mariusmym/Macro-Keypad/SCHEMATIC/Schematic_REFLOW_PLATE_CS2024_v1.2.2_2026-10-07.png

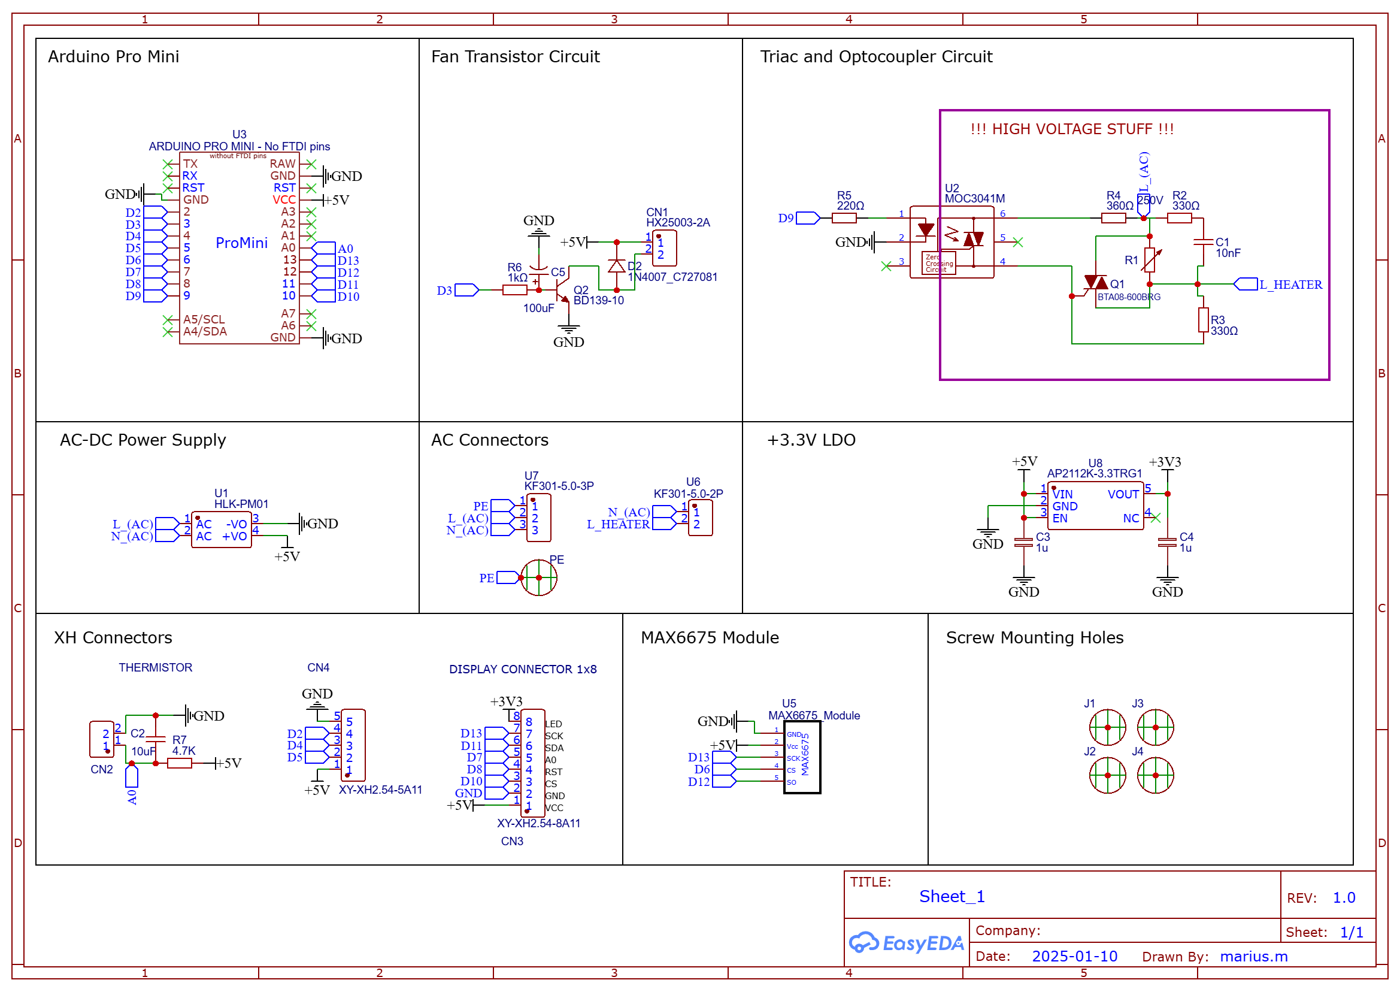
SCHEMATIC/Schematic_REFLOW_PLATE_CS2024_v1.2.2_2026-10-07.png
