mariusmym/Macro-Keypad/GERBER, BOM/BOM_macroKeypad.csv

ID | Name | Designator | Footprint | Quantity | Manufacturer Part | Manufacturer | Supplier | Supplier Part
1 | 1N4148W | D1,D2,D3,D4,D5,D6,D7,D8,D9 | SOD-123_L2.8-W1.8-LS3.7-RD | 9 | 1N4148W | KEXIN | LCSC | C369920
2 | Neopixel | L0 | SK6812-3228 | 1 | SK6812 MINI-E | aliexpress |  | SK6812 MINI-E
3 | Neopixel | L1,L2,L3,L4,L5,L6,L7,L8,L9 | SK6812-3228 | 9 | SK6812 MINI-E | aliexpress | Aliexpress | SK6812 MINI-E
4 | Pro Micro | P1 | MICRO-USB/ USB-C PRO MICRO - 5V | 1 |  |  |  | https://www.aliexpress.com/w/wholesale-pro-micro-atmega32u4.html
5 | 1K | R1 | 0805 | 1 | 080500F1003T5E | UniOhm | LCSC | C149504
6 | 330 | R2 | R0805 | 1 | RC0805JR-07330RL | YAGEO | LCSC | C105877
7 | MX1A | S0A0,S1,S2,S3,S4,S5,S6,S7,S8,S9 | MX1A | 10 | MX SWITCH |  |  | https://www.aliexpress.com/w/wholesale-mx-switch.html
8 | K2-1102DP-E4SW-04 | SW1 | KEY-TH_4P-L6.0-W6.0-P4.50-LS6.5 | 1 | K2-1102DP-E4SW-04 | HRO | LCSC | C136684
9 | PEC11R-4015F-S0024 | SW2 | BOURNS_PEC11R-4XXXF-SXXXX | 1 | PEC11R-4015F-S0024 | BOURNS | LCSC | C143789
10 | SSD1306 | U0 | HDR-4X1/2.54 | 1 | SSD1306 0.91" OLED DISPLAY 128X32 |  |  | https://www.aliexpress.com/w/wholesale-ssd1306-oled--0.91-display-128x64-.html
